mametarou967/FactoryDataViewerClaude/spec/design.md

# Design

## システム構成図
```
[エッジユニット × 最大22台]
  Pico + E220
  ・パトライト監視 (TSL2561 × 3)
  ・電流監視 (CTL-24-CLS + MCP3208)
         ↕ LoRa（ポーリング型）
[ゲートウェイ: app.py（Flask統合アプリ）]
  Raspberry Pi 5 + USB E220
  ┌─ ポーリングスレッド（バックグラウンド）
  │    1分周期: P/Cコマンド → CSV書き込み
  ├─ コマンドキュー（スレッドセーフ）
  │    メンテ操作をWebUI→LoRaスレッドへ橋渡し
  └─ Flaskスレッド（HTTPサーバー）
       ・11台の現在状態一覧
       ・時系列グラフ・品目突合せ
       ・メンテナンス画面（Ping/バージョン/設定/OTA）
         ↕ ファイル（CSV読み取り）
[server_file_copy.py（cron独立実行）]
  ・品目データ取得（SMBファイル同期）
```

## GWアプリケーションアーキテクチャ

```
app.py
├─ polling_thread（daemon=True）
│   ├─ 1分周期: 全機械を順次ポーリング（P/Cコマンド）
│   ├─ データ統合 → CSV書き込み
│   ├─ メンテコマンドキュー（g_cmd_q）を監視してメンテ操作を実行
│   │     ・ポーリング前 + ポーリング後の2回ドレイン（取りこぼし防止）
│   │     ・スリープ中も1秒ごとにキュー確認（g_maint_eventで早期起床）
│   │     K(Ping) / H(HW情報) / V(バージョン) / U(OTA)
│   │     → 結果を g_results dict に非同期保存（5分でGC）
│   └─ 連続送信時: e220_recv後に300msウェイト（E220モジュール安定化）
└─ Flask routes
    ├─ /                                          監視画面（全機械状態一覧）
    ├─ /machine/<name>/date/<date>/graph          日別時系列グラフ
    ├─ /machine/<name>/date/<date>/overview       日俯瞰（サマリ+グラフ）
    ├─ /machine/<name>/date/<date>/summary        稼働時間集計
    ├─ /machine/<name>/date/<date>/table          生データテーブル
    ├─ /machine/<name>/date/<date>/status         現在状態
    ├─ /machine/<name>/date/<date>/hinmoku        品目一覧
    ├─ /machine/<name>/date/<date>/hinmoku/<n>          品目グラフ
    ├─ /machine/<name>/date/<date>/hinmoku/<n>/summary  品目稼働集計
    ├─ /machine/<name>/date/<date>/hinmoku/<n>/info     品目手配情報
    ├─ /machine/<name>/month/<ym>/graph           月別グラフ
    ├─ /machine/<name>/month/<ym>/overview        月俯瞰
    ├─ /machine/<name>/month/<ym>/summary         月別稼働集計
    ├─ /maintenance                       メンテナンス画面
    ├─ POST /api/maint                   コマンド発行（K/V/H）→ g_cmd_qにエンキュー
    │     body: {"cmd": "K"|"V"|"H", "machine": "<name>"|"all"}
    │     response: {"req_ids": [...], "targets": [...]}
    └─ GET  /api/maint/result/<req_id>   結果ポーリング
          response: {"status": "pending"|"done", "result": {...}}
          ※ OTA('U')コマンドはPhase5で追加
```

- シリアルポート（E220）はpolling_threadが一元管理
- メンテ操作はFlask側からキュー経由で依頼し、結果を受け取る
- 信頼性: systemdの `Restart=always` でプロセス障害時に自動再起動

## GW設定ファイル構造（案）
```yaml
gw_channel: 2             # 工場番号=CHの規則で割り当て（工場2=CH2, 工場3=CH3, ...）
                          # JP版: CH2=921.0MHz(Zone A), CH3=921.2MHz, CH4=921.4MHz, ...
gw_addr: 0x0000           # GW自身のLoRaアドレス（工場内で固定）
machines:
  - name: "A214"          # 機械1
    patlite_addr: 0x0101  # machine=1, type=patlite
    current_addr: 0x0102  # machine=1, type=current
    patlite_thresholds:       # パトライト点灯判定閾値（lux）。閾値以上=点灯
      red: 200
      yellow: 200
      green: 200
    current_threshold: 3.0   # 加工中判定閾値（A）。閾値以上=加工中
  - name: "B103"          # 機械2
    patlite_addr: 0x0201  # machine=2, type=patlite
    current_addr: 0x0202  # machine=2, type=current
    patlite_thresholds:
      red: 200
      yellow: 200
      green: 200
    current_threshold: 3.0
  # 兼務ユニットの例（機械11）
  - name: "C501"          # 機械11
    patlite_addr: 0x0B03  # machine=11, type=both（兼務）
    current_addr: 0x0B03  # patlite_addr == current_addr で兼務を表現
    patlite_thresholds:
      red: 200
      yellow: 200
      green: 200
    current_threshold: 3.0
```
※ 同一ユニットが両機能を兼務する場合は `patlite_addr == current_addr` を設定する

### LoRaアドレス規則（工場内）
各工場は独自のGW（RPi5 + USB E220）を持ち、チャンネルで工場間を分離する。
工場内のアドレスは `0xMMTT` 形式で構造化する。

```
0xMMTT
  MM: 機械番号（0x01〜0xFF、最大255台）
  TT: ユニット種別
      0x01 = パトライト監視ユニット
      0x02 = 電流監視ユニット
      0x03 = パトライト+電流兼務ユニット
      0x04〜 = 将来拡張（振動・温度など）
0x0000: GW予約
```

| 例 | アドレス | 意味 |
|----|---|---|
| 機械1 パトライト | 0x0101 | machine=1, type=patlite |
| 機械7 電流 | 0x0702 | machine=7, type=current |
| 機械11 兼務 | 0x0B03 | machine=11, type=both |

**ADDL自動設定（firmware）**: DIPスイッチの読み値（DIP1=bit0=patlite, DIP2=bit1=current）をそのまま ADDL（TT部分）として E220 に書き込む。**ADDH（機械番号MM）のみ、ユニットごとに `DESIRED_ADDH` 定数を変更すること**。

### 多工場展開時のチャンネル割り当て例
※ JP版 BW125kHz: CH=N → 920.6+N×0.2 MHz。Zone A(送信OK)はCH0〜14(920.6〜923.4MHz)

| 工場 | チャンネル | 周波数 | アドレス空間 |
|---|---|---|---|
| 工場2 | 2 | 921.0 MHz (Zone A) | 0x0000〜0xFF03（工場内で完結） |
| 工場3 | 3 | 921.2 MHz (Zone A) | 0x0000〜0xFF03（工場内で完結） |
| 工場4 | 4 | 921.4 MHz (Zone A) | 0x0000〜0xFF03（工場内で完結） |

- 工場ごとにGW・config.yaml・app.pyが独立して稼働
- チャンネルが異なるため同一建物内でも電波干渉なし
- 新工場追加 = 新チャンネルを割り当てるだけ
- アドレスから機械番号・ユニット種別を直読みできるため運用・デバッグが容易

## CSVフォーマット（新設計）
- パス: `data/sensor/<機械名>/YYYY-MM-DD.csv`
- 列: `HH:MM:SS, red_lux, yellow_lux, green_lux, current_A`
  - timestamp列は時刻のみ（HH:MM:SS）。日付はファイル名から取得する
- 記録間隔: 1分

## 状態判定ロジック（GW側・機械ごとに適用）

### Step1: 点灯/消灯判定
```
red点灯   = red_lux   >= patlite_thresholds.red
yellow点灯 = yellow_lux >= patlite_thresholds.yellow
green点灯  = green_lux  >= patlite_thresholds.green
加工中     = current_A  >= current_threshold
```

### Step2: 状態判定（優先順位順）
| 緑 | 電流 | 赤 | 黄 | 判定状態 | 表示色 |
|----|---|----|----|---|---|
| ON | any  | any | any | 自動加工中 | green |
| OFF | 加工中 | any | any | 手動加工中 | blue |
| OFF | 加工なし | ON | OFF | アラーム | red |
| OFF | 加工なし | any | ON | 加工完了 | yellow |
| OFF | 加工なし | OFF | OFF | 停止 | gray |

※ 緑点灯が最優先。緑が消えている場合に電流値で自動/手動を区別する。

## 通信プロトコル（確定）

### E220固定アドレスモードとペイロードの関係
以下のコマンド・レスポンス定義は**ペイロードレベル**の記述。
E220固定アドレスモードでは、送信時に実際のUART書き込みバイト列が異なる。

```
GWがE220 UARTに書き込む実バイト列:
  [DEST_ADDR_H][DEST_ADDR_L][CH] + [ペイロード]
  例: [0x01][0x01][0x02]['P']['\r']['\n']
      ← 宛先0x0101(機械1パトライト), CH=2, コマンドP

エッジのE220がUARTに出力するバイト列（ヘッダ除去後）:
  ['P']['\r']['\n']  ← エッジコードはこれだけ受信すればよい
```

エッジが応答を返す際のルール:
- **宛先**: 常にGWアドレス（0x0000）
- **チャンネル**: エッジ自身に設定されたチャンネル（GWと同一）
- エッジコードは `[ADDR_H][ADDR_L][CMD][data...]['\r']['\n']` をUARTに書くだけでよい

### コマンド一覧（GW → エッジ）
全コマンド共通フォーマット（ペイロード）: `[CMD(1byte)]['\r']['\n']`

| コード | 用途 | 備考 |
|---|---|---|
| `'P'` | パトライトデータ要求 | |
| `'C'` | 電流データ要求 | |
| `'K'` | Ping（死活確認） | |
| `'H'` | ハードウェア・E220設定問い合わせ | |
| `'V'` | ファームウェアバージョン問い合わせ | |
| `'U'` | OTA開始 | Phase5で設計 |

### レスポンス一覧（エッジ → GW）
全レスポンス共通: `[ADDR_H][ADDR_L][CMD][...data...]['\r']['\n']`

```
// Ping応答（5バイト）
[ADDR_H][ADDR_L]['K']['\r']['\n']

// パトライト応答（11バイト）
[ADDR_H][ADDR_L]['P'][RED_H][RED_L][YEL_H][YEL_L][GRN_H][GRN_L]['\r']['\n']
  └ lux値: uint16

// 電流応答（7バイト）
[ADDR_H][ADDR_L]['C'][CUR_H][CUR_L]['\r']['\n']
  └ 電流値: uint16, 0.01A単位（例: 1234 = 12.34A）

// バージョン応答（8バイト）
[ADDR_H][ADDR_L]['V'][MAJOR][MINOR][PATCH]['\r']['\n']

// ハードウェア情報応答（11バイト）
[ADDR_H][ADDR_L]['H'][DIP][E220_ADDR_H][E220_ADDR_L][E220_CH][E220_AIR_RATE][E220_TX_POWER]['\r']['\n']
  └ DIP: bit0=パトライト, bit1=電流, bit2-3=予備

// エラー応答（6バイト）
[ADDR_H][ADDR_L]['E'][ERROR_CODE]['\r']['\n']
  └ 0x01=センサー異常, 0x02=未対応コマンド, 0x03=処理タイムアウト
```

### タイムアウト・再送ポリシー
| 項目 | 値 |
|---|----|
| 応答待ちタイムアウト | 2500ms |
| 再送回数 | 0回（再送なし） |
| 無応答時 | スキップして次のユニットへ |
- 再送なしの理由: LoRa TX同士が衝突するリスクがあるため
- タイムアウト2500msの根拠: 9375bps(SF6/BW125kHz)での実測RTT約1100ms + 100ms待機 = 約1200ms。余裕1300ms。
- 最悪ケース: 22ユニット全タイムアウト × 2500ms = 55秒 → 1分以内に収まる ✓
  ※ 兼務ユニットでもP/Cは別トランザクションのため合計22回の送受信となる

### ポーリングシーケンス（1分周期・定期自動実行）
```
GW → Edge[patlite_addr]: パトライトデータ要求 ('P')
Edge → GW: red_lux, yellow_lux, green_lux
GW → Edge[current_addr]: 電流データ要求 ('C')
Edge → GW: current_A
→ 2ユニットのデータを統合して1行のCSVに記録
→ 次の機械へ（全機械完了まで繰り返し、1分以内に完了）
```

### メンテナンス操作（Web UIからオンデマンド実行）
K/H/V/U コマンドは定期ポーリングには含まれない。
Webメンテナンス画面から手動トリガーし、コマンドキュー経由でpolling_threadが実行する。

| コマンド | 用途 | 実行タイミング |
|---|---|---|
| `'K'` Ping | 死活確認（全台 or 個別） | 手動 |
| `'H'` HW情報 | DIP状態・E220設定値確認 | 手動 |
| `'V'` バージョン | ファーム確認（全台 or 個別） | 手動 |
| `'U'` OTA | ファームウェア更新 | 手動（Phase5） |

## デュアルコアアーキテクチャ

### Core0（通信・UI担当）
- LoRa通信（E220コマンド受信・レスポンス送信）
- コマンド解釈・モード管理
- ボタン入力・SSD1306表示
- USBシリアル設定（将来実装）

#### AUX割り込みによるコマンド受信
- AUX(GPIO6) のRISINGエッジで割り込み → `volatile bool g_auxRise = true` をセット
- loop()内で `g_auxRise && Serial2.available() >= 3` を確認してコマンド処理
  - 受信後のRISING: RXバッファにデータあり → 処理する
  - 送信後のRISING: RXバッファ空 → スルー（ステート変数不要）
- これによりloop()はブロックされず、LEDやボタン処理を並行実行可能
- **起動順序**: `setup()` 内でAUX=HIGHを確認（E220初期化完了）してから `attachInterrupt()` を呼ぶ

### Core1（センサー常時サンプリング担当）
- **パトライト**: TSL2561を3ch高速サイクリング
  - 直近1.5秒間の各センサーmax値を保持
  - パトライトが回転するため瞬時値では消灯誤判定が起きるため
  - 積分時間: **13ms / GAIN_1X**（実機確認済み・確定。工場蛍光灯で1000〜2000 lux を正常計測）
- **電流**: MCP3208を高速サンプリング（目標~1kHz）
  - 50/60Hz交流のRMS値を常時計算・更新
- **arduino-picoでの実現方法**: `setup1()` / `loop1()` を使用

### コア間データ共有（mutex保護）
```
shared_data {
    float    patlite_max[3];    // 赤・黄・緑の直近1.5秒max値 (lux)
    float    current_rms;       // 最新RMS電流値 (A)
    bool     sensor_error;      // センサー異常フラグ
    uint32_t core1_heartbeat;   // Core1生存確認カウンタ（loop1()内でインクリメント）
    int16_t  wave_buf[128];     // 電流テストモード用波形バッファ（128サンプル @~1kHz）
    bool     wave_ready;        // true=128サンプル取得完了・Core0が描画可能
}
```
- `#include <pico/mutex.h>` の `mutex_t` を使用
- Core1が書き込み、Core0がコマンド応答・OLED描画時に読み出し

### D1ハートビートLEDによるデュアルコア監視
Core0のみ生存確認では不十分なため、Core1のカウンタを使って両コアを監視する。

```cpp
// Core1: loop1()内でカウンタを更新
void loop1() {
    // センサーサンプリング処理...
    mutex_enter_blocking(&g_mutex);
    g_shared.core1_heartbeat++;
    mutex_exit(&g_mutex);
}

// Core0: 5秒周期でカウンタ変化を確認し、変化があれば100msパルス点灯
// D1_PERIOD_MS = 5000, D1_FLASH_MS = 100
if (now - g_lastHbMs >= D1_PERIOD_MS) {
    g_lastHbMs = now;
    bool core1_alive = (c1hb != g_lastCore1Hb);
    g_lastCore1Hb = c1hb;
    if (core1_alive) {
        g_d1FlashMs = now;
        digitalWrite(PIN_LED_D1, HIGH);  // パルス点灯開始
    }
}
// D1パルス消灯（100ms後）
if (g_d1FlashMs > 0 && (now - g_d1FlashMs >= D1_FLASH_MS)) {
    g_d1FlashMs = 0;
    digitalWrite(PIN_LED_D1, LOW);
}
```
- Core0フリーズ → D1ピカッ停止
- Core1フリーズ → カウンタ不変 → D1ピカッ停止
- 両方正常 → D1が5秒周期で100msピカッと点滅（青）
- **注意**: Wire / Wire1 / SPI は必ずCore0の `setup()` 内で初期化すること
  （arduino-picoは Core1 を Core0 の `setup()` より「前に」起動するため、`setup1()` 内で
  `volatile bool g_setup_done` フラグが true になるまでスピンウェイトし、
  Core0の `setup()` 完了後に `loop1()` が始まるよう同期している）

### ローカルテストモードのセンサー表示
- **通常動作時**: Core1が常時サンプリング → shared_dataにmax/RMSを更新し続ける
- **ローカルテスト時**: スナップショット方式
  - **パトライトテスト**: Core1が更新し続けるpatlite_max[3]をリアルタイム読み出して液晶表示
  - **電流テスト**: Core0が `g_wave_capture` フラグを立てる → Core1が128サンプル（~128ms）を
    wave_buf[]に蓄積 → wave_ready=true → Core0がOLEDに波形描画（128px幅×48px高） + RMS値表示
  - [SEL]ボタンで新規キャプチャ、[BK]でメニューへ戻る

## 電流計測回路（MCP3208 + CTL-24-CLS）

### 回路構成（回路図: docs/電流測定ユニットの回路図（抜粋）.png）

```
VCC(3.3V)
  │
 R2(10k)
  ├──── C1(47μF) ──── GND    ← DCバイアス安定化
  │
  ├──── [MCP3208 CH0] ←── 計測点
  │
[CTL-24-CLS 白線] ─ R1(33Ω) ─ [CTL-24-CLS 黒線]
                                    │
                                   GND
 R3(10k)
  │
 GND
```

- **R2=R3=10kΩ** 分圧: VCC(3.3V)/2 = **1.65V DCバイアス**（AC電圧の中点）
- **C1=47μF**: DCバイアス安定化（バイパスコンデンサ）
- **R1=33Ω**: CTL-24-CLSのバーデン抵抗（最大安全電流~100Aピーク・0〜30A高精度計測）
- **D5, D6 ツェナー**: 過電圧クランプ保護（CTL-24-CLS内蔵±3.0Vpクランプとの二重保護）
- **MCP3208 CH0**: 電流計測専用チャンネル（CH1〜CH7は未接続）
- **SPI**: CLK=GPIO18, MISO=GPIO16, MOSI=GPIO19, CS=GPIO17, VREF=VCC=3.3V, 1MHz

### CTL-24-CLS 変換式

データシート記載の出力電圧計算式:
```
Eo = K · Io · RL / n  (Vrms)
  Eo: 出力電圧 (Vrms)
  K : 結合係数（データシートK特性グラフ参照）
  Io: 貫通電流 (Arms)
  RL: 負荷抵抗 = 33Ω
  n : 公称変流比 = 2000
```

**K=1近似（Io ≥ 10A）**:
```
Eo_rms = Io × 33 / 2000  (Vrms)
→ Io = Eo_rms × (2000/33) ≈ Eo_rms × 60.6  (Arms)
```

K係数の実態（データシートK特性グラフより）:
| 電流 Io | K値 | 備考 |
|---|-----|---|
| 1A | ≈0.75 | 低電流域・誤差大 |
| 10A | ≈0.95 | 実用範囲内 |
| 50A | ≈1.0 | 工場機械の通常稼働域 |
| 300A | 1.0 | 定格 |

工場機械の稼働電流（通常10A以上）ではK=1近似で実用上問題なし。
稼働判定閾値付近(3A程度)はK≈0.8だが、ON/OFF判定目的では許容範囲。

### firmware 変換手順（Core1実装）

```
【MCP3208 ADC読み取り → 電流値(Arms)】

1. ~1kHzでCH0をサンプリング（100ms窓 = 50Hzで5サイクル分）
2. DC除去: v_ac[i] = raw[i] - DC_OFFSET
     DC_OFFSET = 2048  (= 1.65V / 3.3V × 4096)
3. RMS計算: v_rms = sqrt( sum(v_ac[i]^2) / N )
4. 電圧換算: Vac_rms = v_rms × (3.3 / 4096)  [V]
5. 電流換算: Io = Vac_rms × 60.6 [Arms]   ※ n/RL = 2000/33 ≈ 60.6  (R1=33Ω確定済み)
```

### ADC分解能と測定精度

VREF=3.3V, 12bit → 1LSB = 0.806mV

| 電流 | Eo_rms | ADC RMSカウント | 備考 |
|---|---|---|---|
| 1A | 16.5mV | ~20カウント | ノイズフロア付近 |
| 3A | 49.5mV | ~61カウント | 稼働判定閾値付近 |
| 10A | 165mV | ~205カウント | 実用範囲 |
| 30A | 495mV | ~614カウント | 高精度計測ターゲット上限 |
| 100A↑ | — | ADC飽和 | 100Aピーク超で飽和（ADC破損なし） |

### 電流計測ノイズ対策（実施済み）

**問題**: 無負荷時に ~1.15A のノイズフロア
**原因**: Pico の 3.3Vレール（VCC）が 3.2〜3.397V, 1〜2μs オーダーで揺れる
- C1(47μF) が DC バイアス(1.65V)を安定化するため、バイアス点は VCC 変動に追従しない
- VREF = VCC に直結のため VREF は即座に変動
- ADC = (V_in / VREF) × 4096 の分母だけ揺れる → ノイズとして計測される

**実施した対策**:
1. **R1変更**: 10Ω → **33Ω**（100Aピーク保護 + 0〜30A高精度化）
   - 最大安全電流: 100Aピーク（ADC入力 1.65±1.49V, 3.3V以内）
   - ADCカウント: 30A時 614カウント（10Ω比で約3.3倍の分解能）
   - ノイズフロア: ~0.5A前後（推定値、実測後にCURRENT_NOISE_FLOOR_Aで補正）
2. **VREF 安定化**: MCP3208 VREF(pin15)–AGND(pin14) 間に **10μF + 100nF セラミック並列**を追加
3. **C1交換**（任意・未実施）: 47μF 電解 → 10μF + 100nF セラミック並列（安全性向上）
4. **ノイズフロア補正（ソフト）**: I_real = sqrt(I_meas² - N²) を firmware に実装済み
   - `CURRENT_NOISE_FLOOR_A` 定数（各ユニットで0A実測後に設定）

### サンプリング設計

- **レート**: ~1kHz（SPI 1MHz・13クロック/サンプル → 理論max~75kHz、1kHzで十分）
- **ウィンドウ**: 100ms（50Hzで5サイクル、60Hzで6サイクル → 安定したRMS値）
- **更新タイミング**: 100msごとにg_shared.current_rmsを更新（mutex保護）
- **DC_OFFSET**: 固定値2048を使用（R2=R3で中点が安定しているため動的計算不要）

## エラー報告フレームワーク

`reportError()` 関数が Serial / D4(赤LED) / OLED の3系統を同時制御する。

### エラー種別と優先度（setup()内チェック順）

| 優先度 | エラー内容 | 致命的 | Serial | D4(赤) | OLED |
|---|---|---|---|---|---|
| 1 | OLED(SSD1306)通信不可 | No | ✅ | ✅ | ✗（使用不可） |
| 2 | DIP1/DIP2 両方OFF | **Yes（halt）** | ✅ | ✅ | ✅ |
| 2.5 | E220未検出（AUX 3秒タイムアウト） | No※ | ✅ | ✅ | ✅ 3秒表示後続行 |
| 3 | TSL2561初期化失敗（パトライト） | No | ✅ | ✅ | ✅ 3秒表示後続行 |

※E220未検出は非致命的（センサー・ローカルUI・テストモードはE220不要のため続行）。LoRa通信は機能しない。

### 動作詳細
- **fatal=true**: OLED表示後 `while(true)` でhalt。再起動が必要。
- **fatal=false**: OLED 3秒表示後に通常動作へ続行。D4は点灯し続ける。
- **OLED不可時**: `g_oled_ok=false` のためSerial + D4のみ（縮退動作）

### 優先度設計の根拠
1. OLEDを最初に確認することで、後続エラーをOLEDに表示可能にする
2. DIPエラーはユニット種別が不明なため動作続行不可（halt）
3. センサー失敗は部分的に動作可能（1chのみ失敗など）のため非致命的

### 将来追加候補
- E220設定読み書き失敗（現状はSerialのみ・デフォルト値で続行）
- MCP3208異常（読み値が一定期間飽和など）

## エッジ動作モード
| モード | 遷移条件 | 実装状況 |
|---|---|---|
| 通常動作 | 起動時のデフォルト | ✅ |
| 設定/テストメニュー | OKボタン長押し | ✅ |
| ローカルテスト | 設定メニューから選択 | ✅ |
| エラーhalt | 致命的エラー発生時（DIP両OFF等） | ✅ |
| LoRa経由リモート設定 | GWからの設定コマンド | 将来実装 |
| USBシリアル経由設定 | PCからのコマンド | 将来実装 |
| OTA受信 | GWからのOTAコマンド | 将来実装（Phase5） |

## Phase 5: OTA プロトコル

### フラッシュレイアウト（RP2040, 2MB）
```
0x000000 ─── Bank A (1MB): 現行ファーム（起動・実行）
0x0FFFFF
0x100000 ─── Bank B (1MB): OTA受信バッファ
0x1FFFFF
```
- `XIP_BASE` = 0x10000000（メモリマップアドレス）、flash API は物理オフセットで操作
- Bank B 物理オフセット = 0x100000
- 書き込み単位: 256B ページ（`FLASH_PAGE_SIZE`）、消去単位: 4KB セクター（`FLASH_SECTOR_SIZE`）
- **Arduino IDE での通常書き込みは Bank A (オフセット 0) に行われるため影響なし**

### OTA 状態遷移
```
IDLE → (UI受信) → INIT: Bank B消去 → READY送信
INIT → (UD受信ループ) → RECV: CRC16検証・Bank B書き込み → ACK/NACK
RECV → (UF受信) → FIN: Bank全体CRC32検証 → マジック書き込み → DONE送信 → reboot
RECV/FIN → (UA受信) → IDLE: マジック消去
```

### GW → Edge コマンド（payload フィールド）

| コマンド | 識別子 | サイズ | フィールド |
|---|---|---|---|
| INIT | `UI`  | 13B  | `UI` + total_size(4B,BE) + total_crc32(4B,BE) + chunk_size(2B,BE) + reserved(1B) |
| DATA | `UD`  | 7+N B | `UD` + seq(2B,BE) + chunk_crc16(2B,BE) + len(1B=128) + data(N B) |
| FIN | `UF`  | 6B | `UF` + total_size(4B,BE) |
| ABORT | `UA`  | 4B | `UA` + code(1B) + padding(1B) |

最終チャンクは len < 128 の可能性あり（`UD` の len フィールドで通知）。

### Edge → GW レスポンス

| レスポンス | 識別子 | サイズ | フィールド |
|---|---|---|---|
| READY | `UR`  | 8B | `[ADDR_H][ADDR_L]UR` + chunk_size(2B,BE) + CR + LF |
| ACK | `UK`  | 10B  | `[ADDR_H][ADDR_L]UK` + seq(2B,BE) + next_seq(2B,BE) + CR + LF |
| NACK | `UN`  | 9B | `[ADDR_H][ADDR_L]UN` + seq(2B,BE) + err(1B) + CR + LF |
| DONE | `UD`  | 10B  | `[ADDR_H][ADDR_L]UD` + crc32(4B,BE) + CR + LF |
| FAIL | `UF`  | 9B | `[ADDR_H][ADDR_L]UF` + code(1B) + reason(2B) + CR + LF |

### CRC
- **チャンク単位**: CRC16-CCITT（poly=0x1021, init=0xFFFF）
- **全体検証**: CRC32/IEEE（Python: `zlib.crc32(data) & 0xFFFFFFFF`）

### OTA 適用フラグ（Bank B 末尾 16B）
```
XIP_BASE + 0x1FFFF0:  "OTA_READY"(9B) + fw_size(4B,BE) + padding(3B)
```
- `applyOTA_impl()` は RAM から実行（`__no_inline_not_in_flash_func`）
- `requestCore1Pause()` で Core1 を協調停止（volatile フラグベース）
  - ※ `multicore_lockout_victim_init()` は arduino-pico の SIO_IRQ_PROC1 ハンドラと衝突するため不使用
- Bank A 消去**前**に `watchdog_enable(5000, false)` で WDT を有効化
- Bank A 消去・Bank B→A コピー完了後、`WATCHDOG_LOAD` レジスタに 2 を直書きして即時リセット発火
  - ※ Bank A 消去後は SDK 関数（`watchdog_reboot` 等）が呼べないためレジスタ直操作が必要

### タイムアウト・再送ポリシー
- GW→Edge: 1チャンクあたり 3.5秒タイムアウト（RTT ~1.5s + 余裕 2s）
- NACK 受信時: GW はエラーとして OTA 中止（手動リトライ方式）
- FIN 後の DONE 待ち: 10秒（Bank B CRC32 計算時間を考慮）

### OTA 所要時間目安（SF6/BW125kHz, RTT 1.5s/chunk）
| チャンク数 | ファームサイズ | 合計時間 |
|---|---|---|
| 156 | 20KB | 約 4分  |
| 781 | 100KB | 約 20分 |
| 1563 | 200KB | 約 39分 |

→ 実運用は深夜バッチ or 手動メンテ窓での実行を推奨。

## 既存GWとの差分（プロトタイプ → 本番）
| 項目 | プロトタイプ | 本番 |
|---|---|---|
| 台数 | 2台 | 最大22台 |
| 通信方式 | イベント駆動 | ポーリング型 |
| データ保存 | 1ファイル | 機械ごとサブディレクトリ |
| 状態判定閾値 | app.py内ハードコード | 設定ファイルで管理 |
