mametarou967/FactoryDataViewerClaude/docs/電流測定ユニットの回路図（抜粋）.png

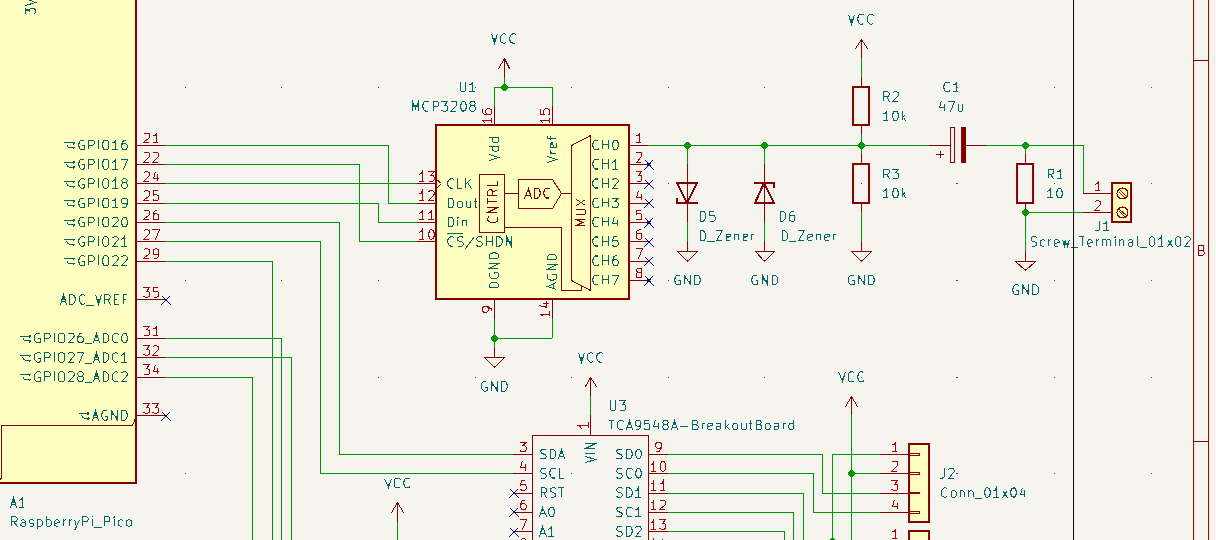
docs/電流測定ユニットの回路図（抜粋）.png
