mametarou967/FactoryDataViewerClaude/hardware/PatliteCurrentMonitoringUnit.kicad_sch

## KiCad design hardware/PatliteCurrentMonitoringUnit.kicad_sch (2026-02-21)

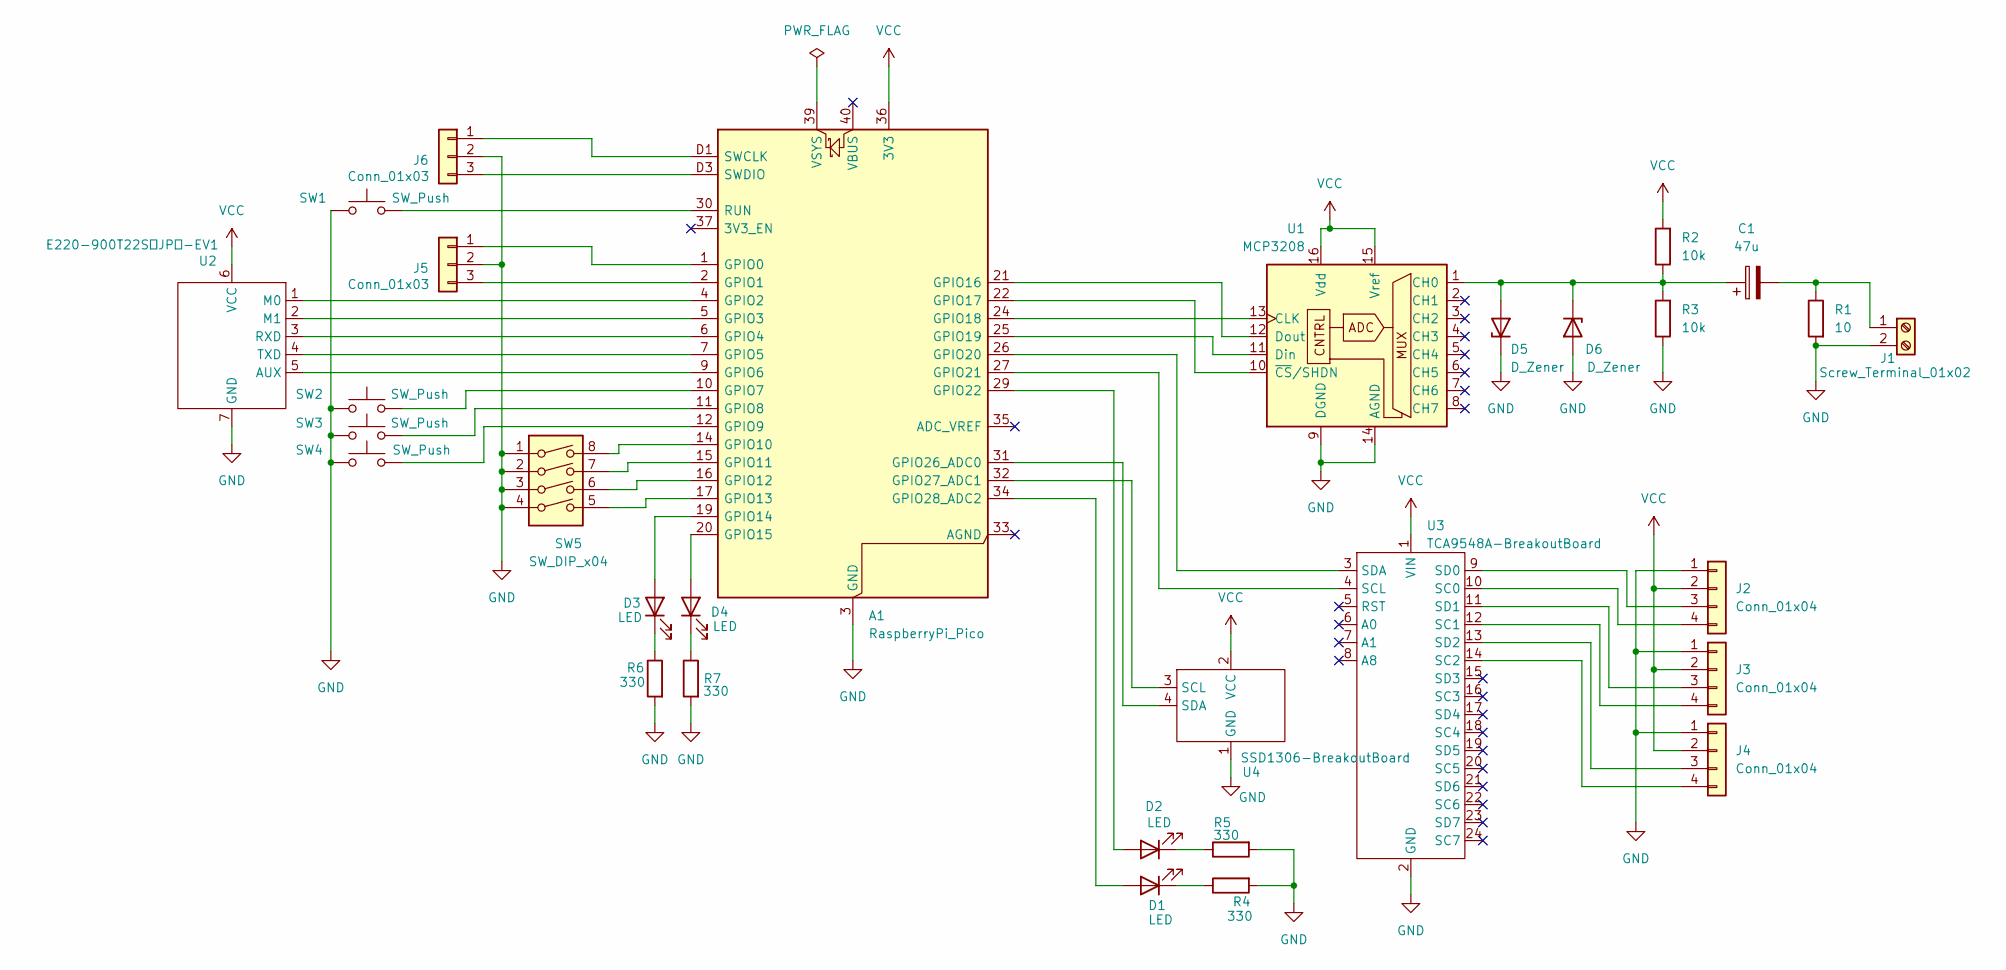
[picture p2: schematic PatliteCurrentMonitoringUnit.kicad_sch]

Parts:
A1: RaspberryPi_Pico; RaspberryPi_Pico_SMD_HandSolder
C1: 47u; CP_Radial_D6.3mm_P2.50mm
D1, D2, D3, D4: LED; LED_D3.0mm
D5, D6: D_Zener; D_DO-35_SOD27_P7.62mm_Horizontal
J1: Screw_Terminal_01x02; TerminalBlock_Phoenix_MKDS-1,5-2-5.08_1x02_P5.08mm_Horizont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
J2, J3, J4: Conn_01x04; NS-Tech_Grove_1x04_P2mm_Vertical
J5, J6: Conn_01x03; PinHeader_1x03_P2.54mm_Vertical
R1: 10; R_Axial_DIN0207_L6.3mm_D2.5mm_P7.62mm_Horizontal
R2, R3: 10k; R_Axial_DIN0207_L6.3mm_D2.5mm_P7.62mm_Horizontal
R4, R5, R6, R7: 330; R_Axial_DIN0207_L6.3mm_D2.5mm_P7.62mm_Horizontal
SW1: SW_Push; SW_PUSH_6mm_H7.3mm
SW2, SW3, SW4: SW_Push; SW_PUSH-12mm
SW5: SW_DIP_x04; DIPx4
U1: MCP3208; DIP-16_W7.62mm
U2: E220-900T22S（JP）-EV1; E220-900T22SJP-EV1
U3: TCA9548A-BreakoutBoard
U4: SSD1306-BreakoutBoard

Connections:
GND: A1.3 (GND), A1.8 (GND), A1.13 (GND), A1.18 (GND), A1.23 (GND), A1.28 (GND), A1.38 (GND), A1.D2 (GND), D5.1 (K), D6.2 (A), J1.2, J2.1, J3.1, J4.1, J5.2, J6.2, R1.2, R3.1, R4.2, R5.2, R6.2, R7.2, SW1.1, SW2.1, SW3.1, SW4.1, SW5.1, SW5.2, SW5.3, SW5.4, U1.9 (DGND), U1.14 (AGND), U2.7 (GND), U3.2 (GND), U4.1 (GND)
unnamed: A1.1 (GPIO0), J5.1
unnamed: A1.2 (GPIO1), J5.3
unnamed: A1.4 (GPIO2), U2.1 (M0)
unnamed: A1.5 (GPIO3), U2.2 (M1)
unnamed: A1.6 (GPIO4), U2.3 (RXD)
unnamed: A1.7 (GPIO5), U2.4 (TXD)
unnamed: A1.9 (GPIO6), U2.5 (AUX)
unnamed: A1.10 (GPIO7), SW2.2
unnamed: A1.11 (GPIO8), SW3.2
unnamed: A1.12 (GPIO9), SW4.2
unnamed: A1.14 (GPIO10), SW5.8
unnamed: A1.15 (GPIO11), SW5.7
unnamed: A1.16 (GPIO12), SW5.6
unnamed: A1.17 (GPIO13), SW5.5
unnamed: A1.19 (GPIO14), D3.2 (A)
unnamed: A1.20 (GPIO15), D4.2 (A)
unnamed: A1.21 (GPIO16), U1.12 (Dout)
unnamed: A1.22 (GPIO17), U1.10 (~CS/SHDN)
unnamed: A1.24 (GPIO18), U1.13 (CLK)
unnamed: A1.25 (GPIO19), U1.11 (Din)
unnamed: A1.26 (GPIO20), U3.3 (SDA)
unnamed: A1.27 (GPIO21), U3.4 (SCL)
unnamed: A1.29 (GPIO22), D2.2 (A)
unnamed: A1.30 (RUN), SW1.2
unnamed: A1.31 (GPIO26_ADC0), U4.4 (SDA)
unnamed: A1.32 (GPIO27_ADC1), U4.3 (SCL)
unnamed: A1.34 (GPIO28_ADC2), D1.2 (A)
unnamed: A1.D1 (SWCLK), J6.1
unnamed: A1.D3 (SWDIO), J6.3
unnamed: C1.1, D5.2 (A), D6.1 (K), R2.1, R3.2, U1.1 (CH0)
unnamed: C1.2, J1.1, R1.1
unnamed: D1.1 (K), R4.1
unnamed: D2.1 (K), R5.1
unnamed: D3.1 (K), R6.1
unnamed: D4.1 (K), R7.1
unnamed: J2.3, U3.9 (SD0)
unnamed: J2.4, U3.10 (SC0)
unnamed: J3.3, U3.11 (SD1)
unnamed: J3.4, U3.12 (SC1)
unnamed: J4.3, U3.13 (SD2)
unnamed: J4.4, U3.14 (SC2)
VCC: A1.36 (3V3), J2.2, J3.2, J4.2, R2.2, U1.15 (Vref), U1.16 (Vdd), U2.6 (VCC), U3.1 (VIN), U4.2 (VCC)
