mametarou967/FactoryDataViewerClaude/(commit log)

2026-02-21 Initial commit: プロジェクト構成・既存コード・設計仕様
    - CLAUDE.md: システム仕様・ピンアサイン・通信設計を記録
    - hardware/: KiCadスケマティック・ネットリスト
    - firmware/sandbox/: 既存センサー読み取りコード（輝度・電流）
    - gateway/: 既存GWプロトタイプ（lora_logger, server_file_copy, app）
    - .gitignore: Python/Arduino/KiCad/データファイルを除外
    [PatliteCurrentMonitoringUnit.kicad_sch]
2026-02-21 Add .steering/ docs and slim down CLAUDE.md
    - .steering/requirements.md: エッジ・GW・Webの要件定義
    - .steering/design.md: アーキテクチャ・CSVフォーマット・通信設計
    - .steering/decisions.md: 設計判断とその理由
    - .steering/tasklist.md: Phase1〜5の実装タスク一覧
    - CLAUDE.md: ピンアサイン・センサー仕様のクイックリファレンスに整理
2026-02-21 Add LED assignment
    D1(GPIO28)=ハートビート, D2(GPIO22)=LoRa通信状態
    D3(GPIO14)=センサー異常, D4(GPIO15)=モード表示
    パネル引き出し・前面視認可能
2026-02-21 Phase1完了: パケットフォーマット確定
    - design.md: 通信プロトコル全コマンド・レスポンス・タイムアウト仕様を記載
    - tasklist.md: Phase1を完了済みにマーク
2026-02-21 ドキュメント整備: 残課題3点を修正
    - design.md: GW設定ファイルにpatlite_thresholdsを追加
    - tasklist.md: Phase2をStep1〜5に細分化、K/H/Vコマンドタスク追加
    - decisions.md: パケットフォーマット・LED・段階的実装の判断理由を追記
2026-02-21 デュアルコアアーキテクチャを設計に追加
    - design.md: Core0/Core1の役割分担・共有データ構造を記載
    - decisions.md: パトライト回転問題とデュアルコア採用理由を記録
    - tasklist.md: Step3をデュアルコア構成に更新
2026-02-21 ドキュメントレビュー反映: 4件の不整合を修正
    - design.md: ローカルテストをスナップショット方式に明記
    - design.md: Core0でのWire/SPI初期化制約を注記
    - design.md: setup1()/loop1()によるマルチコア実現方法を明記
    - CLAUDE.md: TSL2561積分時間を要実機確認に変更
    - CLAUDE.md: SSD1306ライブラリ候補を明記
2026-02-21 docs: ドキュメント整合性修正5件
    ①requirements.md: 電流ローカルテスト表示をリアルタイム→スナップショット方式に修正
    ②CLAUDE.md: ライブラリヘッダの「確定済み」を削除（SSD1306はStep4で確定）
    ③tasklist.md Phase3: K/H/V コマンド送信タスクをGW側に追加
    ④design.md: GW設定YAMLにgw_addr（GW自身のLoRaアドレス）を追加
    ⑤tasklist.md Step4: E220設定の保存先を「Flashに保存」→「E220のE2PROMに書込み」に修正
2026-02-21 docs: AUX割り込みによるコマンド受信方式を設計に反映
    - tasklist.md Step1: AUX割り込み受信基盤・起動時AUX待ちを追加
    - tasklist.md Step2: 受信ループタスクを削除（Step1で完結）
    - design.md Core0: AUX割り込み方式の詳細を追記
    - decisions.md: AUX割り込み方式の決定を記録
    - decisions.md: E220設定保存先（E2PROM）の決定を記録
2026-02-21 docs: GWアプリをFlask統合構成に設計変更
    - decisions.md: app.py + lora_logger.py 統合の決定を記録
    （シリアルポート排他・メンテUI要件が統合を選択する決め手）
    - design.md: GWアーキテクチャ図を統合構成に更新
    （ポーリングスレッド + コマンドキュー + Flaskスレッド）
    - design.md: K/H/V/UをメンテUI経由オンデマンド実行と明確化
    - tasklist.md: Phase3/4を統合してStep1〜4に再構成
    （基盤・監視UI・メンテUI・運用対応）
    - CLAUDE.md: ファイル構成をapp.py統合版に更新
2026-02-21 docs: 状態判定ロジックと電流閾値構造を設計に反映
    - design.md: GW設定YAMLのcurrent_thresholds(3値)を
    current_threshold(1値)に修正
    - design.md: 状態判定ロジック（点灯判定→状態判定の2段階）を追記
    - design.md: CSVのtimestamp列がHH:MM:SSのみ（日付はファイル名）を明記
    - decisions.md: 電流閾値は2値判定・状態5種・優先ルールを記録
2026-02-21 docs: D1ハートビートをCore0+Core1の両コア監視に変更
    - requirements.md: D1説明を「両コアが生きているときのみ点滅」に更新
    - design.md: shared_dataにcore1_heartbeatカウンタを追加
    - design.md: updateHeartbeat()の実装例を追記
    - decisions.md: D1のデュアルコア監視実装方針を記録
2026-02-21 docs: 多工場対応のLoRaチャンネル分離設計を追加
    - design.md: GW設定YAMLにgw_channelを追加
    - design.md: 工場内アドレス規則テーブルを追記
    - design.md: 多工場展開時のチャンネル割り当て例を追記
    - decisions.md: チャンネル分離による多工場対応の決定を記録
    各工場が独立したGW+config.yamlを持ち、チャンネルで分離する方式。
    工場内アドレスは0x0000〜0x0016を毎回同じ規則で割り当て。
2026-02-21 docs: LoRaアドレスを0xMMTT形式に変更（拡張性向上）
    - design.md: アドレス規則を連番から0xMMTT形式に変更
    MM=機械番号(0x01〜0xFF), TT=ユニット種別(01=パトライト,02=電流,03=兼務,04〜=拡張)
    - design.md: GW設定YAMLのサンプルアドレスを新形式に更新
    - design.md: 兼務ユニットの設定例を追加
    - decisions.md: 0xMMTT形式採用の決定と理由を記録
2026-02-21 docs: レビュー指摘3件を修正
    - CLAUDE.md: D1ハートビートLED説明をデュアルコア監視版に更新
    - decisions.md: mutex保護対象にcore1_heartbeatを追加
    - tasklist.md: 「11台」のハードコード表現をconfig.yaml準拠に変更
2026-02-21 docs: DIPスイッチとLoRaアドレスTTの整合ルールを明記
    設定ミス防止のため、DIPのON/OFFとアドレスTT（ユニット種別）を
    必ず一致させる運用ルールをrequirements.mdに追記。
2026-02-21 feat: gateway HTMLテンプレート群を追加
    プロトタイプ版app.pyが参照するJinja2テンプレート一式。
    再実装時の参照・仕様確認用として管理対象に追加。
2026-02-21 docs: E220固定アドレスモードの実装注意事項を追記
    - E220ペイロードレベルとUART実バイト列の違いを明記
    - GW送信時の[DEST_ADDR_H][DEST_ADDR_L][CH]+ペイロード形式を追記
    - エッジの応答先ルール（常にGW=0x0000、同一チャンネル）を明記
    - タイムアウト計算の「22ユニット」を「11機械×2コマンド」に修正
2026-02-21 feat(firmware): Phase2 Step1 - E220基本通信実装
    - E220ドライバ: モード切替（通常/設定）、AUX=HIGH待ち
    - 起動時にE220 E2PROMから設定を読み取り（ADDH/ADDL/CH/REG0/REG1）
    - AUX割り込み（RISING edge）によるコマンド受信基盤
    - Serial2.available() >= 3 で受信/送信後を区別（ステート変数不要）
    - attachInterrupt()はAUX=HIGH確認後に呼び出し
    - コマンド対応: K(Ping) / V(Version) / H(HW情報) / E(Error)
    - P/Cは ERR_UNKNOWN_CMD を返す（Step2で実装）
    - D1: Core0ハートビート1秒点滅（Step3でCore1生存確認を追加予定）
    - D2: LoRa通信状態（受信成功で点灯、5分無通信で消灯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
    [edge_unit.ino]
2026-02-21 feat(tools): E220エッジユニット テストスクリプト追加
    Ubuntu PC + USB E220（GW役）からK/V/Hコマンドを送信し、
    エッジの応答をパース・表示するテストツール。
    使い方:
    python3 tools/test_edge.py [--port /dev/ttyUSB0] [--addr 0x0101] [--ch 18]
2026-02-21 fix: E220コンフィグモードを9600bps対応・自動設定書き込み追加
    firmware/edge_unit:
    - コンフィグモード(M0=M1=HIGH)は常に9600bps固定のため
    serial2Begin()で都度ボーレートを切り替えるよう修正
    - 読み取り対象を7バイト(REG3まで)に拡張、reg3フィールド追加
    - e220WriteConfig()を新規追加（C0コマンドでE2PROM永続書き込み）
    - e220ConfigureIfNeeded()で起動時に設定確認・差分があれば自動書き込み
    - DESIRED_*定数でユニットごとの目標設定値を管理
    tools/gw_e220_config.py:
    - GW E220設定ツール（DIPスイッチでM0=M1=HIGH後に実行）
    - 現在設定読み取り・表示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
    [edge_unit.ino, gw_e220_config.py]
2026-02-21 fix: E220レジスタマップ修正（NETIDフィールド除去）
    E220-900T22S実機確認でNETIDがレジスタ0x02に存在しないことが判明。
    レジスタマップを6バイト構成に修正:
    0x00:ADDH 0x01:ADDL 0x02:REG0 0x03:REG1 0x04:CHAN 0x05:REG3
    - 読み書きを C1/C0 00 06 (6バイト) に変更
    - NETID除去、パース修正
    firmware/edge_unit/edge_unit.ino:
    - E220Config構造体からnetId除去
    - 読み書きを6バイトに変更
    - DESIRED_NETID定数除去
    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
    [edge_unit.ino, gw_e220_config.py]
2026-02-22 feat(debug): 通信診断ツール追加（hexDump・レジスタ詳細表示・AUX監視）
    - edge_unit: hexDump()でRX/TX生バイト列をダンプ
    - edge_unit: e220PrintConfig()で全レジスタをパースして表示（起動時）
    - edge_unit: sendToGW()後にAUX LOW→HIGH時間を監視してLoRa TX完了を確認
    - test_edge.py: hex_dump()でGW側のTX/RX生バイト列をダンプ
    - test_edge.py: タイムアウトを3000ms・リトライ0に変更（9.6kbps RTT対応）
    調査結果: GW E220 USBモジュールのLoRa RXが機能していない可能性が高い
    - Edge→GW方向: 固定モード・透過モード・ブロードキャスト・beaconいずれも0バイト
    - G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
2026-02-23 fix(e220): JP版データシート準拠に全面修正・CH2/9600bpsで通信確認
    - E220-900T22S/22L(JP)のレジスタマップに準拠して修正
    - REG0エアレート: 海外版3bit→JP版5bit(SF/BW複合)
    - REG1 TX電力: 海外版2bit(22dBm基準)→JP版4bit(最大13dBm)
    - REG3 WORビット位置: bits[3:1]→bits[2:0]
    - パリティフィールド表示を削除（JP版に存在しない）
    - DESIRED_REG1: 0x00(未定義)→0x01(13dBm, 22S JPデフォルト)
    - DESIRED_CHANNEL: 18(868MHz, 帯外)→2(921.0MHz, 日本Zone A)
    - UART: 115200bps→9600bps(双方向通信確認済み設定)
    - sendToGW()に100ms待機追加（即時応答問題対策）
    - JP版データシー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
    [edge_unit.ino, gw_e220_config.py, test_edge.py]
2026-02-23 docs: 不整合修正（Phase2 Step1完了・チャンネル・タイムアウト・型番）
    - tasklist.md: Phase2 Step1を全タスク完了済み[x]に更新
    - design.md: gw_channel 18→2(921.0MHz, JP版Zone A)
    - design.md: 多工場チャンネル例 18/19/20→2/3/4(JP版周波数付き)
    - design.md: タイムアウト 500ms/再送1回→3000ms/再送0回(実装値に合わせる)
    - design.md: プロトコル例のCH=18(0x12)→CH=2(0x02)
    - requirements.md: E220型番に(JP)を明記(エッジ・GW両方)
    - CLAUDE.md: ファイル構成にtools/を追加、edge_unitのコメント修正
2026-02-23 fix: タイムアウト2500msに変更・test_edge.pyのデフォルトCH修正
    - タイムアウト 3000ms→2500ms
    根拠: 22ユニット全タイムアウト時 22×2500ms=55秒 < 60秒
    実測RTT~1100ms+100ms待機=1200ms、余裕1300ms確保
    - test_edge.py DEFAULT_CHANNEL 18→2 (CH2=921.0MHz, Zone A)
    - design.md タイムアウト・最悪ケース計算を2500msベースに更新
    [test_edge.py]
2026-02-23 docs: 工場番号=CHの規則を明記、ino コメント・バグ修正
    - decisions.md: タイムアウト500ms→2500ms修正、工場番号=CH番号の規則を明記（工場2=CH2, 工場3=CH3...）
    - design.md: gw_channelコメント・多工場テーブルを工場番号=CH番号の規則に合わせて修正（工場1/2/3→工場2/3/4）
    - edge_unit.ino: e220ReadConfig/WriteConfigのコメントをNETIDなし・正しいバイト数に修正
    - edge_unit.ino: e220WriteConfigタイムアウトパスのserial2Begin(115200)→9600バグ修正
    - 動作確認: K/V/H 3/3 ALL PASS
    [edge_unit.ino]
2026-02-23 docs: JP版対応コメント細部修正
    - requirements.md: 設定対象の型番に(JP)を追記
    - edge_unit.ino: E220Config構造体コメント修正
    - reg0: パリティフィールドなし（JP版）を明記
    - reg3: LBT→TX電力テーブル(22Lのみ)（JP版bit5の正しい用途）
    [edge_unit.ino]
2026-02-23 fix: test_edge.py の --ch/--baud ヘルプ文字列を正しいデフォルト値に修正
    - --ch: (default: 18) → (default: 2)
    - --baud: (default: 115200) → (default: 9600)
    [test_edge.py]
2026-02-23 feat: Phase2 Step2 P/Cコマンド ダミーデータ応答実装
    - edge_unit.ino: cmdPatlite() / cmdCurrent() 追加
    - P: red=300lux, yel=0lux, grn=500lux のダミー値で応答（uint16 big-endian）
    - C: 1234 (12.34A) のダミー値で応答（uint16 big-endian, 0.01A単位）
    - Step3でCore1の実センサーデータに置換予定
    - test_edge.py: P/Cコマンドのテスト・パース・表示を追加
    - tasklist.md: Step2 完了済みに更新
    - 動作確認: K/V/H/P/C 5/5 ALL PASS
2026-02-24 fix: test_edge.py バナー表示を Step2 に修正
    - run_test()内のprint文: "Phase 2 Step1" → "Phase 2 Step2"
    [test_edge.py]
2026-02-24 feat: Phase2 Step3-1 TSL2561デュアルコア実装・動作確認済み
    - Core1でTSL2561を常時サンプリング（13ms/GAIN_1X）
    - 直近1.5秒maxウィンドウによるパトライト回転対策
    - mutex_tによるコア間共有データ保護（SharedData構造体）
    - DIPスイッチによるユニット種別判定（g_unit_type）
    - cmdPatlite()をダミー値→実センサー値に置換
    - D1ハートビート: Core0+Core1両方が生きているときのみ点滅
    - D3センサー異常LED: TSL2561初期化失敗時に点灯
    - fix: tcaSelect後にdelay(2)追加（CH1 getEvent()が0になる問題を修正）
    - 動作確認: 3ch全て正常計測・1.5秒maxウィンドウ保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
    [edge_unit.ino]
2026-02-25 docs: Step3-1動作確認済みに更新・TSL2561設定値を確定に修正
    - tasklist.md: Step3-1 動作確認チェックを完了マークに更新
    - CLAUDE.md: TSL2561 積分時間を「検討中」→「13ms/GAIN_1X 確定」に修正
    - design.md: 同上
2026-02-25 docs: 電流計測回路設計をdesign.mdに追記・回路図・データシート追加
    - design.md: MCP3208+CTL-24-CLS電流計測回路の設計情報を追記
    （回路構成・変換式・K係数・firmware変換手順・ADC精度・サンプリング設計）
    - docs: 電流測定ユニット回路図(抜粋).png / CTL-24-CLS_2023_J.pdf を追加
2026-02-26 Phase 2 Step3完了: MCP3208電流計測・LED動作改善・DIP自動アドレス設定
    ## firmware (edge_unit.ino)
    - Step3-2: MCP3208 ~1kHzサンプリング + RMS電流計算をCore1に実装
    - DIPスイッチの値をそのままE220 ADDL(TT部分)に自動設定（DESIRED_ADDL廃止）
    - D1(青): 1秒トグル → 5秒周期100msパルスに変更（存在感を抑制）
    - D2(緑): 常時点灯/タイムアウト → LoRa受信のたびに100msピカッに変更
    - D3/D4の役割入れ替え: D3(黄)=モード表示、D4(赤)=センサー異常
    ## ドキュメント
    - requirements.md / CLAUDE.md: LED仕様・DIP自動設定を更新
    - design.md: ADDL自動設定の注記・電流計測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
2026-02-26 docs: design.mdのD1ハートビート仕様を現行実装に合わせて更新、D2色(緑)をドキュメント化
    - design.md: D1ハートビートセクションのコードスニペット・説明を旧仕様(1秒トグル)から
    現行実装(5秒周期・100msパルス)に更新。変数名も実コードに合わせて修正。
    - requirements.md: D2のLED色「緑」を追記
    - CLAUDE.md: D2のLED色「緑」を追記
2026-02-28 feat: 電流計測RL=100Ω対応・ADC診断出力追加
    - R1: 10Ω → 100Ω変更に合わせて変換係数を200→20に修正
    (n/RL = 2000/100 = 20, クリップ~23A・22A超検知用途)
    - ノイズフロア: ~1.3A → ~0.16A に改善
    - ADC診断ログ追加: 100msウィンドウごとにmean/min/max/dc_err/rms_cntを出力
    (mean計算用sum、raw min/max追跡変数を追加)
    [edge_unit.ino]
2026-03-02 docs: 電流計測ノイズ対策を完了マークに更新
    - VREF安定化・R1=100Ω変更・クランプメーター実機確認（10.64A/クランプ10〜11A一致）を完了
    - C1交換（47μF→セラミック）は任意タスクとして残す
2026-03-02 docs: MCP3208入力保護の検討タスクをStep5後に再検討として追記
2026-03-02 docs: R1=100Ω変更を全ドキュメントに反映・不整合修正
    - requirements.md: バーデン抵抗 10Ω → 100Ω
    - design.md: 回路図・変換式(×200→×20)・ADCテーブル・ノイズ対策セクションを100Ω基準に更新
    - tasklist.md: D3センサー異常LED → D4センサー異常LED（LED役割入れ替えの反映漏れ修正）
2026-03-02 refactor: ADC診断ログ削除（デバッグ用コードのクリーンアップ）
    - [ADC] Serial.printf出力を削除
    - 診断用変数(g_current_sum, g_current_raw_min, g_current_raw_max)を削除
    - 計測ロジック本体は変更なし
2026-03-03 feat: Step4 SSD1306 + ボタンUIを実装
    - SSD1306 OLED表示（Wire1: GPIO26/27）
    - 3ボタンUIとデバウンス処理（150ms、any-edgeリセット方式）
    - UIMode: NORMAL/MENU/CONF_VIEW/EDIT_ADDH/EDIT_CHANNEL
    - 設定確認画面（ADDH/ADDL/CH/REG0/REG1/REG3表示）
    - ADDH・CH変更をOLED+ボタンで操作しE2PROMに書き込み
    - メニューモード中はLoRa受信を無視・D3 LED点灯
    - Arduino自動プロトタイプ生成との衝突を避けるため
    UIMode enum・BtnState structをinclude直後に移動
2026-03-03 feat: ConfView展開表示+スクロール、Edit±1操作に変更
    ConfView:
    - 生レジスタ値に加え、デコード済み8項目を表示
    (addr/CH/UART/Air rate/SF+BW/Pkt+Pwr/RSSI/Mode+WOR)
    - SELキーでスクロール（7行表示、2ポジション）
    Edit ADDH/Channel:
    - BACK=-1（デクリメント）、SEL=+1 に変更
    - OKは値未変更時はE2PROM書き込みをスキップ
2026-03-03 feat: ConfViewに生レジスタ値行(R0/R1/R3)を追加
    9行目として "R0:xx R1:xx R3:xx" を追加。
    スクロールポジションを0-2（3段階）に拡張。
2026-03-03 feat(Step5): ローカルテストモード実装
    - UIMode に MODE_TEST_PATLITE / MODE_TEST_CURRENT を追加
    - SharedData に wave_buf[128] / wave_ready フィールドを追加
    - Core1: g_wave_capture フラグで128サンプル波形キャプチャ（~1kHz）
    - OLED: Patlite tst → 3ch lux値リアルタイム表示
    - OLED: Current tst → AC波形スナップショット（上48px）+ RMS値表示
    - drawWaveform() ヘルパー追加（128px幅×48px高、クリップ付き）
    - メニュー: 4項目→6項目に拡張（Patlite tst / Current tst 追加）
    - .steering/tasklist.md: Step5 チェック完了
2026-03-03 fix: メンテ中（黄LED点灯時）は青ハートビートLEDを消灯
    - D1点灯トリガーに g_uiMode == MODE_NORMAL 条件を追加
    - メニュー移行時に点灯中だった場合も即消灯（タイムアウト待ち不要）
    [edge_unit.ino]
2026-03-03 feat: ユニット種別に応じてメニュー項目を動的構築
    - MenuItem 構造体 + g_menuItems[]/g_menuCount を追加
    - buildMenu() でパトライト/電流ユニット非搭載時は該当テスト項目を非表示
    - handleUI/updateOLED を動的メニュー参照に変更
    - setup() でユニット種別確定直後に buildMenu() 呼び出し
2026-03-03 docs: ドキュメントの不整合を修正
    - decisions.md: D3/D4の用途が逆だったのを修正（D3=モード表示黄, D4=センサー異常赤）
    - decisions.md: D1点滅周期「1秒」→「5秒周期100msパルス」に修正、メンテ中抑制を追記
    - design.md: shared_dataに wave_buf[128]/wave_ready を追記
    - design.md: ローカルテストモードの設計記述を実装に合わせて更新
    （「shared_dataに波形バッファ不要」という古い記述を削除）
    - CLAUDE.md: SSD1306ライブラリをAdafruit確定表記に更新
2026-03-06 feat: DIP設定エラーを3系統（Serial/LED/OLED）で通知
    - SSD1306初期化をLED init直後に前出し（DIPチェック前にOLED使用可能に）
    - DIP1/DIP2 両方OFF時: Serialエラー出力 + D4(赤)点灯 + OLED error画面表示 + halt
    - OLEDには原因と対処（DIP1=patlite / DIP2=current / reboot）を表示
    [edge_unit.ino]
2026-03-06 feat: エラー報告を3系統（Serial/D4/OLED）に統一・優先度管理
    - reportError() 関数を追加（Serial + D4点灯 + OLED表示を一括処理）
    - fatal=true: halt（再起動要求）
    - fatal=false: OLED 3秒表示後続行
    - g_oled_ok=false 時はSerial + D4のみ（OLED不可時の縮退動作）
    - [優先度1] OLED(SSD1306)通信不可: Serial + D4のみ通知
    - [優先度2] DIP1/DIP2 両方OFF: Serial + D4 + OLED + halt（致命的）
    - [優先度3] TSL2561初期化失敗: Serial + D4 + OLED 3秒表示後続行（失敗CHを表示）
    - g_oled_ok グローバルフラグ追加（OLED初期化成否を管理）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
2026-03-06 docs: design.mdにエラー報告フレームワーク追加・不整合修正
    - エラー報告フレームワークセクション追加（優先度・3系統出力・設計根拠）
    - エッジ動作モードテーブルを実装状況付きに更新（エラーhalt追加、将来実装を明記）
    - Core0担当の「USBシリアル設定」を「将来実装」と明記
    - AUX割り込みコード例の変数名を auxRise → g_auxRise に修正
2026-03-06 fix: SSD1306未接続をI2Cスキャンで確実に検出
    Adafruit_SSD1306::begin()はNACKを検出しない場合があるため、
    Wire1.beginTransmission()+endTransmission()でACK/NACKを直接確認する。
    - endTransmission()==0: ACK → begin()へ進む
    - endTransmission()!=0: NACK → reportError(Serial+D4のみ)
    [edge_unit.ino]
2026-03-06 fix: E220 AUX待ち中にSerial進捗ドットを出力
    e220WaitAuxHigh()でAUX=HIGH待ち中に500ms毎に"."を出力。
    OLEDエラー等で画面が使えない状態でも処理が止まっているか
    進行中かをSerialで確認できる。
    [edge_unit.ino]
2026-03-06 feat: E220未接続をタイムアウトで検出・reportErrorで3系統通知
    - e220WaitAuxHighTimeout(ms)を追加（起動時チェック専用・タイムアウト付き）
    - 既存e220WaitAuxHigh()はモード切替用として維持（無限待ち）
    - setup()でAUX=HIGH待ちを3秒タイムアウトに変更
    - 未検出時: reportError(Serial+D4+OLED) + e220ConfigureIfNeeded()をスキップ
    （スキップしないと内部のe220WaitAuxHigh()で無限ハングするため）
2026-03-06 docs: E220未検出エラーをdesign.mdのエラー一覧に追記
2026-03-06 fix: エラー表示・LED動作を改善、TSL2561初期化リトライ追加
    - g_hw_error フラグ追加: D4(赤)がハートビートブロックで5秒後に消灯するバグを修正
    - OLEDエラー表示の継続: reportError()後も通常画面に戻らず g_hw_error 表示を維持
    - D1ハートビートをg_hw_error中は抑制（エラー中に正常動作と誤認させない）
    - AUX pin を INPUT_PULLDOWN に変更（E220未接続時に確実にLOWで検出）
    - TSL2561初期化に最大3回リトライ追加（USB差し込み時の電源立ち上がり不安定対策）
    - initPatliteSensors() の直接 digitalWrite(D4) を削除（reportError経由で統一）
    Co-Authored-By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
    [edge_unit.ino]
2026-03-07 fix: Core0/Core1レースコンディションによるGRN lux=0バグを修正
    arduino-picoはCore0のsetup()より前にCore1を起動するため、
    g_tsl_ok[]が初期化される前にloop1()が読み取ってしまい
    GRN(TCA CH2)のlux値が常に0になるバグがあった。
    修正内容:
    - g_tsl_ok, g_setup_doneをvolatileに変更（コンパイラキャッシュ防止）
    - setup1()にg_setup_done待ちスピンループを追加
    - setup()末尾でg_setup_done=trueをセット（AUX割り込み有効化直後）
    - MODE_TEST_PATLITEのOLEDにok:YYY形式のセンサー初期化状態を表示
    docs: design.mdのsetup1()起動タイミング説明を事実に合わせて修正
    Co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
    [edge_unit.ino]
2026-03-09 feat: 電流計測R1を33Ωに変更、ノイズフロア補正を追加
    R1変更（100Ω → 33Ω）の目的:
    - 100Aピークまで安全に受け入れ可能（ADC入力 1.65±1.49V, 3.3V以内）
    - 0〜30A高精度計測（30A時614カウント、従来比3.3倍の分解能）
    - ツェナー不要で100Aピーク保護を実現
    ソフト変更:
    - 変換係数を n/RL=2000/100=20 → 2000/33≈60.6 に更新
    - ノイズフロア補正 I_real=sqrt(I_meas²-N²) を実装
    - CURRENT_NOISE_FLOOR_A定数（0.0fで無効、実測後に各ユニット設定）
    実機確認: 誤差0.5A以内（許容範囲内）
2026-03-09 docs: R1=33Ω変更に伴うドキュメント整合性修正
    - tasklist.md: R1変更履歴を100Ω→33Ωに訂正、100A突入対策を完了に更新
    - design.md: 回路図ASCII内のR1(100Ω)→R1(33Ω)に修正
    - requirements.md: 100Ω抵抗の記述を33Ωに修正
2026-03-10 feat(gateway): GW基盤・ポーリング + Web UI 多機械対応 (Phase3&4 Step1)
    - gateway/config.yaml 新規作成（serial/LoRa設定・machines配列）
    - E220ドライバ追加（e220_send/recv, parse_patlite/current）
    - polling_loop スレッド追加（60秒周期・SerialException自動リトライ）
    - write_sensor_csv: data/sensor/<machine>/YYYY-MM-DD.csv へ書き込み
    - get_light_status に thresholds/current_threshold 引数追加
    - Flask routes を /machine/<name>/date/<date>/ 体系に移行
    - 旧 /date/ /month/ URL は 302 リダイレクトで後方互換維持
    - テンプレート全体の URL を machine_name 付きに更新
    - use_reloader=False 追加（werkzeug 2重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
2026-03-11 feat(gateway): メンテナンスWeb UI実装 + spec/ディレクトリ再構成 (Phase3&4 Step3)
    ## gateway/app.py
    - POST /api/maint, GET /api/maint/result/<req_id> エンドポイント追加
    - GET /maintenance ルート追加
    - _handle_maint() 実装: K(Ping)/V(Version)/H(HW情報)コマンド送受信・結果パース
    - g_results/g_res_lock/g_maint_event グローバル変数追加（非同期結果管理）
    - polling_loop 改善:
    - ポーリング前後の2回キュードレイン（ポーリング中コマンドの取りこぼし防止）
    - スリープ中1秒ごとのキュー確認（g_maint_event + empty()チェック）
    - e220_recv後300msウェイト（E220モジュール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
2026-03-11 docs: ドキュメント整合性修正
    - spec/design.md: hinmoku/<n>/info ルートを追記
    - CLAUDE.md: app.py の「再実装予定」を削除（実装済みのため）
2026-03-13 feat: Phase 5 OTA実装 (LoRa経由ファームウェア更新)
    - firmware: OTA状態機械・フラッシュ書込み関数追加
    - INIT/DATA/FIN/ABORT ハンドラ実装
    - デュアルバンク方式 (Bank A=稼働中, Bank B=OTAバッファ)
    - 起動時マジックワード確認 → applyOTA_impl で Bank A 上書き
    - applyOTA_impl 先頭でマジックセクター消去（再起動ループ防止）
    - multicore_lockout によるデュアルコア安全停止
    - rxBuf を 200B に拡張
    - gateway: OTAワーカースレッド + Flask OTA APIルート追加
    - /api/ota/upload, /api/ota/start/<job_id>, /api/ota/progress/<job_id>
    - crc16_ccitt / crc32 検証、チャンク分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
2026-03-13 fix: Serial2.end()→begin() 繰り返しによる起動ハング修正
    Serial2.begin() が内部で irq_set_exclusive_handler() を使用するのに対し、
    Serial2.end() は irq_remove_handler() で除去するため、2回目以降の呼び出しで
    USB CDC (tud_task) の状態が破壊され delay() がハングする問題を修正。
    対策:
    - serial2Begin() の初回呼び出しのみ完全初期化（Serial2.end() を呼ばない）
    - 2回目以降は RX バッファのクリアのみ実施（ボーレートは常に 9600bps 固定のため）
    - setup1() の while ループを delay(1) → tight_loop_contents() に変更し
    Core1 から tud_task() が呼ばれる TinyUSB 競合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
    [edge_unit.ino]
2026-03-13 fix: multicore_lockout_victim_init を loop1() 初回実行時に移動
    multicore_lockout_victim_init() を setup1() で呼ぶと位置に関わらず問題が発生する:
    - 先頭(g_setup_done前): Serial2.begin() がハングして起動3行で止まる
    - 末尾(g_setup_done後): Core1 が起動しない（電流計測が 0.00A 固定）
    OTAコマンドは LoRa 経由で届くため、loop1() の初回実行（数μs以内）より
    必ず後になる。loop1() 初回で multicore_lockout_victim_init() を呼ぶことで:
    - setup() の Serial2.begin() との競合を完全に回避
    - Core1 が正常に起動し電流計測が動作
    - OTA ロックアウトも問題なく機能
    Co-Authore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
    [edge_unit.ino]
2026-03-13 fix: multicore_lockout を協調的pause機構に置き換え（Core1 panic 修正）
    multicore_lockout_victim_init() が arduino-pico の SIO_IRQ_PROC1 ハンドラと
    衝突し、Core1 が起動直後に panic してシャットダウンする問題を修正。
    原因: arduino-pico は SIO_IRQ_PROC1 に irq_set_exclusive_handler() で
    独自ハンドラを登録済み。multicore_lockout_victim_init() が同じ IRQ に
    再登録しようとして panic() → Core1 がシャットダウン。
    どのタイミングで呼んでも（setup1先頭/末尾/loop1初回）同様に失敗する。
    対策: pico/multicore.h および multicore_lockout_*() を全廃し、
    volatile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
    [edge_unit.ino]
2026-03-13 fix(ui): 起動画面拡大・ボタン割り当て統一・表記修正
    1. MODE_NORMAL: addr/CH行をサイズ2（大文字）に拡大
    - addr:0xMMTT と CH:N を16px高の大文字で表示
    - ユニット種別とバージョンを同行（サイズ1）にまとめ
    2. Conf view: [BK]でのみ戻れるよう変更（[OK]では戻らない）
    - ヒント: [BK]ret → [BK]back
    3. Edit ADDH/CHAN: ボタン表記を [S] → [SEL] に統一
    4. Patlite tst: センサー状態表示を ok: → tsl: に変更（意味を明確化）
    - [OK]では戻らない（[BK]のみで戻る）
    5. Current tst: [SEL]波形キャプチャ機能を削除
    - [BK]のみで戻れるよう変更（[O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
    [edge_unit.ino]
2026-03-13 fix(ui): 起動画面のアドレス表示はみ出し修正
    "addr:0x0101"をsize2で表示すると11文字×12px=132px>128pxで
    最終文字がCH行に折り返す問題を修正。
    ラベル(size1)と値(size2)を分離したレイアウトに変更:
    y=0-7: "Addr:" size1
    y=8-23: "0xMMTT" size2 (6文字×12px=72px、収まる)
    y=24-31: "CH:" size1
    y=32-47: "<ch番号>" size2
    y=48-55: unit+ver size1
    y=56-63: "[OK]Menu" size1
    [edge_unit.ino]
2026-03-13 GW: メンテ画面ユニット別コマンド・P/C手動取得・ログ画面追加
    - maintenance.html: 1機械2行(patlite/current)構成に変更
    - 各行に K/V/H + P(lux) または C(A) ボタン追加
    - unitパラメータ対応（特定ユニットへのコマンド投げ）
    - app.py: /api/maintにP/C対応・unitパラメータ追加
    - _handle_maint()でP(lux x3)・C(電流A)のレスポンス解析追加
    - 'P'/'C'コマンドを許可・unitによる対象フィルタ
    - app.py: RotatingFileHandlerでファイルログ追加(gateway/logs/app.log)
    - E220接続/切断・メンテコマンド結果・OTA開始/完了/失敗を記録
    - log.html: 新規作成 — /logページ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
2026-03-13 chore: gateway/logs/ を .gitignore に追加
2026-03-13 test: OTA確認用にバージョンを v1.0.0 → v1.1.0 に変更
    OTA成功後、メンテナンス画面の V(Version) コマンドで
    1.1.0 が返れば書き換え成功の確認ができる。
2026-03-13 fix(ota): OTA DATAパケット受信中のCRLF誤検出バグを修正
    バイナリファームウェアには 0x0D 0x0A が任意の位置に出現するため、
    OTA DATAパケット('UD'...)受信中にCRLF終端チェックが早期にtrueになり
    pktlen < 7+dlen でNACK 0x12 が発生していた。
    修正: is_ota_data フラグで OTA DATA と通常パケットを分岐し、
    OTA DATA時はCRLFチェックを禁止・dlen完了のみで終了する。
    [edge_unit.ino]
2026-03-13 test: OTA確認用バージョン v1.1.0 → v1.2.0
    USB書込み済みのv1.1.0(OTAバグ修正済み)に対して
    OTA経由でv1.2.0を送ることで動作確認する。
    [edge_unit.ino]
2026-03-13 fix(ota): INIT後のREADY待ちタイムアウトを4s→60sに延長
    Bank B 1MB消去 (64KBブロック×16) は最悪25秒かかるため
    4秒タイムアウトでは INIT timeout になることがある。
    [app.py]
2026-03-13 debug: add pktlen/dlen print before NACK 0x12 in handleOtaData
    Adds Serial.printf to show pktlen, dlen, and required length just
    before the 0x12 (short packet) check so that OTA failures can be
    diagnosed via the Serial Monitor.
    [edge_unit.ino]
2026-03-14 fix: expand Serial2 FIFO to 256B for OTA DATA packet reception
    OTA DATA packets are 135 bytes but the default arduino-pico Serial2
    ring buffer is 32 bytes (RP2040 hardware FIFO size). This caused
    truncation at 31 bytes → pktlen=31 < 7+128=135 → NACK 0x12.
    Added Serial2.setFIFOSize(256) before Serial2.begin() in serial2Begin().
    Also bumps version to 1.3.0 to verify OTA success via V command.
    [edge_unit.ino]
2026-03-14 fix(ota): replace memcpy/memset with RAM-resident versions in applyOTA_impl
    After flash_range_erase(Bank A), the XIP cache is invalidated.
    Calling libc memcpy/memset (which reside in Bank A flash) causes a
    cache miss, fetches 0xFF, executes invalid instructions, and triggers
    HardFault. This was the root cause of the post-OTA hang (green LED
    permanently on, edge silent).
    Fix: add ram_memcpy() and ram_memset() with __no_inline_not_in_flash_func
    to ensure they run from RAM throughout the Bank A erase/program cycle.
    Also bump version to v1.3.1.
    [edge_unit.ino]
2026-03-14 bump: v1.3.1 → v1.3.2 for OTA verification build
2026-03-14 fix(ota): replace watchdog_reboot(0,0,0) with hw TRIGGER bit write
    watchdog_reboot(0, 0, 0) internally calls watchdog_enable(delay_ms=0)
    which panics with "Watchdog delay out of range" in the pico SDK.
    The device was hanging in panic after successfully completing the
    Bank B→Bank A copy loop (firmware WAS correctly written to Bank A).
    Fix: use hw_set_bits(&watchdog_hw->ctrl, WATCHDOG_CTRL_TRIGGER_BITS)
    which is an inline register write, runs entirely from RAM, and causes
    an immediate hardware reset without depending on any flash code.
    Also add hardware/watchdog.h include and bump version to v1.3.3.
    [edge_unit.ino]
2026-03-14 fix(ota): use ARM SYSRESETREQ for chip reset in applyOTA_impl
    Previous attempts:
    - watchdog_reboot(0,0,0): panics in pico SDK (delay_ms=0 out of range)
    - hw_set_bits(WATCHDOG_CTRL_TRIGGER_BITS): no effect on RP2040
    (TRIGGER bit does not cause immediate reset on this chip)
    Fix: write to SCB->AIRCR (0xE000ED0C) with SYSRESETREQ bit:
    *((volatile uint32_t*)0xE000ED0C) = 0x05FA0004u;
    This is the ARM Cortex-M0+ standard software reset mechanism.
    It compiles to a single inline store instruction (runs from RAM),
    works with interrupts disabled, and causes immediate chip reset.
    Also bump version to v1.4.4.
    [edge_unit.ino]
2026-03-14 fix: RP2040リセット方法をウォッチドッグ直接レジスタ書き込みに変更 (v1.5.5)
    SYSRESETREQはRP2040 TRMで非推奨（ウォッチドッグ使用を明示要求）のため、
    applyOTA_implのリセット処理をウォッチドッグレジスタ直接操作に変更。
    CLEAR alias→TICK(12MHz XOSC設定)→LOAD(4000ticks≈2ms)→SET ENABLEの順で書き込み。
    Bug #1: memcpy HardFault → ram_memcpy/ram_memset (fixed v1.3.1)
    Bug #2: watchdog_reboot(0) panic → replaced (fixed v1.3.3)
    Bug #3: WATCHDOG_CTRL_TRIGGER_BITS no-op → replaced (fixed v1.4.4)
    Bug #4: SYSRESETREQ no-op on RP2040 → direct WDT register writes (THIS fix)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
    [edge_unit.ino]
2026-03-14 fix: applyOTA_impl リセット方法を確定（v1.6.0）
    Bank A 消去後に直接ウォッチドッグレジスタを書いても機能しない問題の根本解決。
    watchdog_enable() (SDK関数・Bank Aフラッシュ在中) を Bank A 消去 *前* に呼び出し、
    WDT を有効化(5s timeout)しておく。消去+コピー完了後は LOAD=2 を書くだけで
    次のティック(~1µs)でリセット発火する。
    Bug history:
    #1: ram_memcpy/memset (v1.3.1)
    #2: watchdog_reboot panic (v1.3.3)
    #3: TRIGGER bit no-op (v1.4.4)
    #4: SYSRESETREQ no-op (v1.5.5)
    #5: direct WDT regs after Bank A erase (→ this fix, v1.6.0)
    [edge_unit.ino]
2026-03-15 chore: serial_port を /dev/ttyUSB0 に更新
2026-03-15 docs: spec/design.md の OTA リセット方法を実装に合わせて更新
    - multicore_lockout → requestCore1Pause() (volatile フラグベース) に修正
    - watchdog_reboot(0,0,0) → watchdog_enable(5000) + LOAD=2 直書き に修正
    - arduino-pico との衝突理由も補足
2026-03-16 fix: E220 addH/channel を起動時に上書きしないよう修正 (v1.6.2)、A215 設定追加
    - e220ConfigureIfNeeded(): addH/channel はE220自身の不揮発メモリを信頼し
    コンパイル時定数で上書きしないよう変更。未設定値(0x00/0xFF)時のみデフォルト使用。
    これによりボタンUIで設定したアドレス・チャンネルが電源OFF/OTA後も維持される。
    - config.yaml: A215 (patlite=0x0201, current=0x0202) を追加
    [config.yaml, edge_unit.ino]
2026-03-17 feat: トップページのカレンダー・加工状況を機械ごとに切り替え可能に
    - ?machine=A215 クエリパラメータで対象機械を選択可能（デフォルト: 先頭機械）
    - カレンダー上部に機械選択ボタンを追加（選択中はハイライト表示）
    - カレンダー・加工状況・リンク先が選択機械に連動して切り替わる
